i5lab/7DOF-Robotic-ARM/2nd Project (Build)/Report.pdf

a

# ساخت سه درجه آزادی اول

## universal

-UR5

فروغ افخمی 6003889

علی بهمنیار 6003880

سینا ربیعی 6003839

سمیرا سلجوقی 6003880

دکتر شریفی

زمستان 8888

ساخت ربات 2

## فهرست

## اهداف و فرآیند پروژه 3 انتخاب نحوه فیدبک و actuator 4

## انتخاب موتور 5 طراحی اجزای ربات در Solidworks 6

## پرینت سهبعدی و برش لیزری لینکها و صفحات 7 بخش مکانیکی پروژه 8

شفت 8
کوپلینگ 9
بلبرینگ 9
انواع پیچ و مهره و واشر 10

## مراحل ساخت ربات 11 بخش طراحی کنترلر پروژه 12

مراحل طراحی کنترل کننده 12

13 | Anti-wind up | عملکرد | نحوه
به دست آوردن ضرایب کنترلکننده 13

### 3 ساخت ربات

## اهداف و فرآیند پروژه

ربات پروژه ما ربات سری 9 درجه آزادی 5UR از شرکت universal است که در پروژه اول درس به شبیه سازی کامل آن در متلب پرداختیم و در پروژه عملی به ساخت ربات با 3 درجه آزادی اول آن می پردازیم و در ادامه با استفاده از کنترلر based-error آن را کنترل می کنیم.

مراحل این پروژه به شرح زیر می باشد:

- انتخاب نوع موتور مناسب و نحوه فیدبک گرفتن
- طراحی کامل اجزا و قسمت های ربات در نرم افزار solidworks
- پرینت سه بعدی قطعات
- خرید موتور ها و تجهیزات مورد نیاز
- ساخت ربات براساس طراحی
- برقراری ارتباط متلب با آردوینو
- ایجاد یک کنترل کننده based_error

ساخت ربات 4

## انتخاب نحوه فیدبک و actuator

برای کنترل موقعیت بازوی ربات، میبایست از یک سیستم کنترلی حلقه بسته استفاده شود، برای ایجاد این سیستم به یک فیدبک از موقعیت بازو نیازمندیم، برای ایجاد این فیدبک میتوانیم از روشهای زیر استفاده کنیم:

.8 انکودر چرخشی افزایشی)Encoder Incremental Rotary)

این نوع از انکودرها به ازای هر دور موتور تعدادی پالس روی دو فاز مختلف ایجاد میکنند، با شمارش تعداد این پالسها میتوان میزان چرخش موتور را تعیین کرد و با توجه به اختلاف فاز میان دو فاز میتوان جهت چرخش را مشخص نمود، این نوع فیدبک اما به صورت نسبی است به این معنا که تنها میتوان میزان تغییر موقعیت موتور را با استفاده از آن به دست آورد و موقعیت موتور را به صورت مطلق نمیتوان در اختیار داشت. در این روش میزان تغییر موقعیت موتور به صورت دقیق به دست میآید و این روش نسبت به نویز تا حد خوبی مقاوم است.

.0 پتانسیومتر)Potentiometer)

با استفاده از یک پتانسیومتر متصل به شفت موتور میتوان موقعیت شفت را با استفاده از تقسیم ولتاژ میان مقاومتها به صورت مطلق به دست آورد. با این که این روش موقعیت مطلق شفت را به ما میدهد و از این نظر مناسبتر است اما دارای دقت کمی است واز آن جا که عملاً موقعیت موتور میبایست به صورت آنالوگ مورد خوانش قرار گیرد این روش در برابر نویز حساسیت بیشتری دارد.

.3 انکودر چرخشی مطلق)Encoders Rotary Absolute)

انکودرهای مطلق با قابلیت خوانش دیجیتال که دقت بسیار مطلوبی را فراهم میکنند اما قیمت بسیار بالایی دارند.

در نهایت با توجه به محدودیتهای فیزیکی و مالی استفاده از روش دوم یعنی پتانسیومتر ترجیح داده شد، در این روش با هزینهی کم میتوانیم موقعیت شفت موتور را به صورت مطلق در اختیار داشته باشیم اما از طرف دیگر سیستم حساس به نویز خواهد بود و همچنین پتانسیومتر استفاده شده دارای حدوداً 88 تا 89 درجه dead zone میباشد، به این معنا که در این ناحیه خروجی ثابت مانده و با تغییر موقعیت شفت موتور سیستم قادر به تشخیص این تغییر نخواهد بود.

برای خواندن موقعیت موتور با استفاده از پتانسیومتر به واسطهی برد آردوینو )Mega Arduino )، از واحد ADC میکروکنترلر 2560ATmega استفاده میکنیم، این واحد ADC دارای دقت 10 بیتی است بنابراین میتوانیم به صورت تئوری موقعیت موتور را با دقت 360/1024 یعنی 0.351 درجه در اختیار داشته باشیم، اما نویز و zone dead باعث میشوند تا در عمل دقت کمتری داشته باشیم.

برای ایجاد نیروی محرکه میتوانیم از انواع موتورهای الکتریکی استفاده کنیم که موتورهای DC سادهترین آنها میباشند، در موتورهای DC، با تعیین جهت جریان عبوری از موتور میتوان جهت چرخش موتور را تعیین کرد.

### 5 ساخت ربات

برای کنترل توان تحویلی به موتور و نتیجتاً سرعت و گشتاور موتور نیز میتوان از پالس PWM با cycle Duty متغیر استفاده کرد.

برای کنترل جهت جریان عبوری از موتور میتوان از مدار Bridge-H استفاده کرد، با استفاده از این مدار میتوان جهت جریان عبوری از موتور را با ولتاژ مناسب موتور کنترل کرد.

آیسی 298L شرکت STMicroelectronics دارای دو مدار Bridge-H میباشد که برای استفادهی بیان شده بسیار مناسب میباشد.

## انتخاب موتور

موتور مورد نظر برای این پروژه سروو موتور R996 MG دنده فلزی 398 درجه دارای پتانسیومتر است. این موتور دارای مشخصات زیر می باشد که مقدار گشتاور، ابعاد و جرم آن برای پروژه مناسب می باشد. با توجه به نکات ذکر شده در بالا موتور R996MG گزینه مناسبی است زیرا در درون خود دارای فیدبک موقعیت از نوع پتانسیومتر نیز میباشد.برای کنترل این موتور، اتصال موتور به برد خود را قطع کرده ایم و از خروجی پتانسیومتر فیدبک میگیریم.

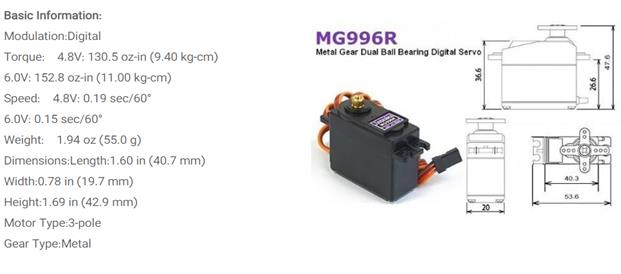
[picture p1: figure]

شکل :8 سرو موتور R996MG به همراه دیتاشیت خلاصه

ساخت ربات 6

## طراحی اجزای ربات در Solidworks

با استفاده از نرم افزار solidworks قسمت های مختلف ربات را با جزئیات کامل طراحی می کنیم. این طراحی شامل یک بیس برای ربات است که موتور اول زیر آن قرار می گیرد. در ادامه آن نیز لینک های دوم و سوم قرار می گیرند. همچنین محل قرار گیری بلبرینگ ها، شفت ها و سایر اتصالات نیز به طور دقیق مشخص می شوند.

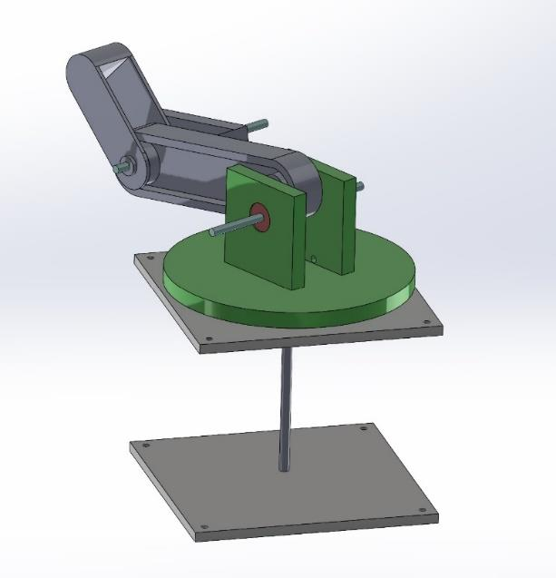
[picture p2: figure]

شکل :0 نمای ربات طراحی شده در Solidworks

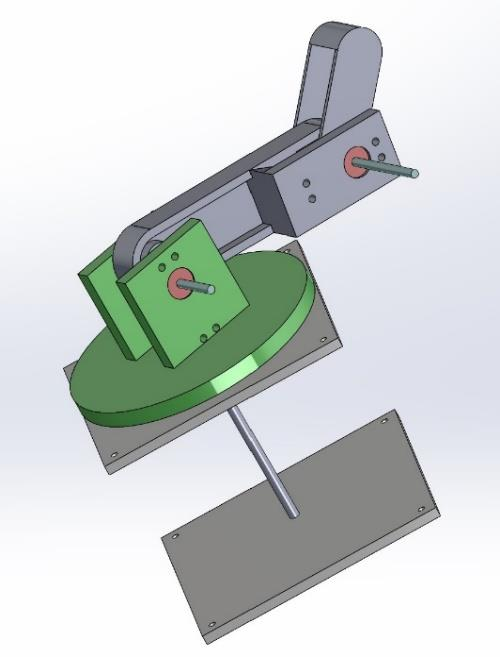
[picture p3: figure]

شکل :3 نمای ربات طراحی شده در Solidworks

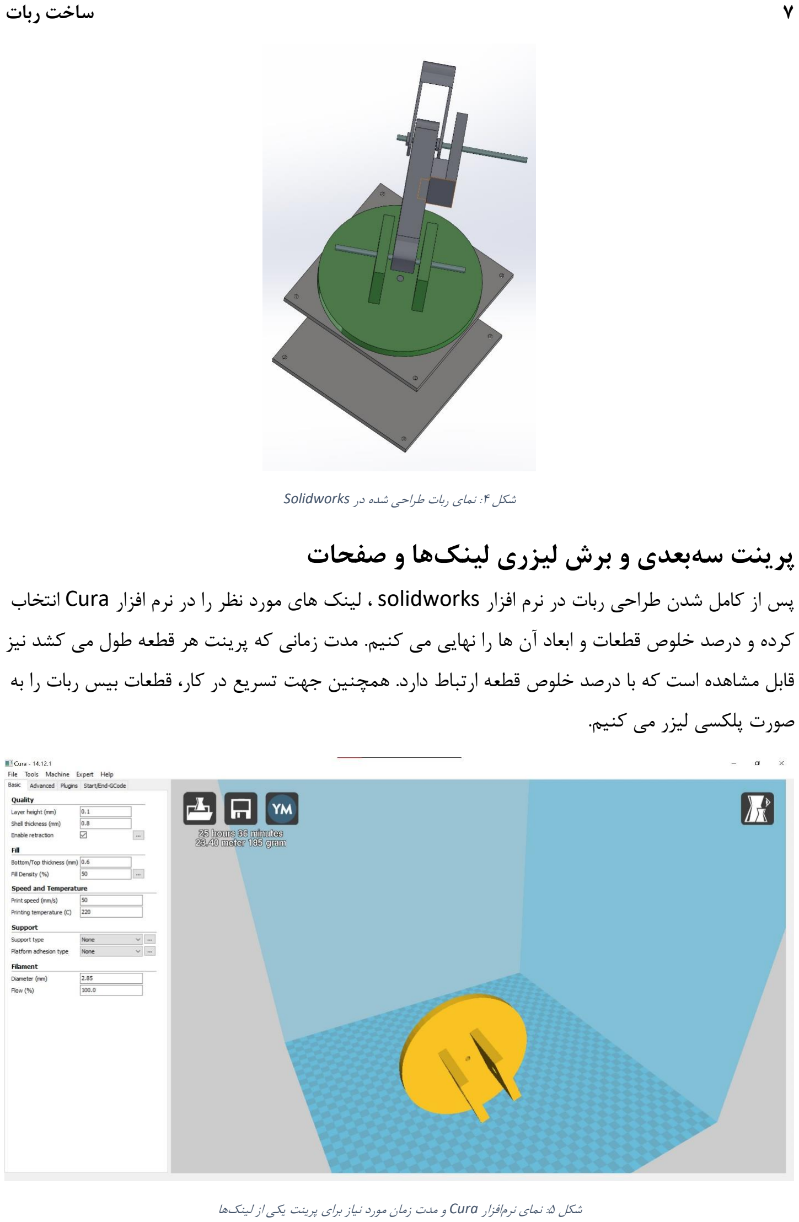
[picture p4: page 7]

### 7 ساخت ربات

شکل :8 نمای ربات طراحی شده در Solidworks

## پرینت سهبعدی و برش لیزری لینکها و صفحات

پس از کامل شدن طراحی ربات در نرم افزار solidworks ، لینک های مورد نظر را در نرم افزار Cura انتخاب کرده و درصد خلوص قطعات و ابعاد آن ها را نهایی می کنیم. مدت زمانی که پرینت هر قطعه طول می کشد نیز قابل مشاهده است که با درصد خلوص قطعه ارتباط دارد. همچنین جهت تسریع در کار، قطعات بیس ربات را به صورت پلکسی لیزر می کنیم.

شکل :9 نمای نرمافزار Cura و مدت زمان مورد نیاز برای پرینت یکی از لینکها

ساخت ربات 8

## بخش مکانیکی پروژه

تجهیزات مکانیکی استفاده شده

.8 شفت
.0 کوپلینگ
.3 بلبرینگ
.8 انواع پیچ و مهره و واشر

شفت
به سه عدد شفت هارد کروم به قطر 9 میلیمتر نیاز داریم تا موتورها را به لینکها متصل کنیم. شفتهای تهیه شده ساخت چین و دارای مشخصات زیر هستند:

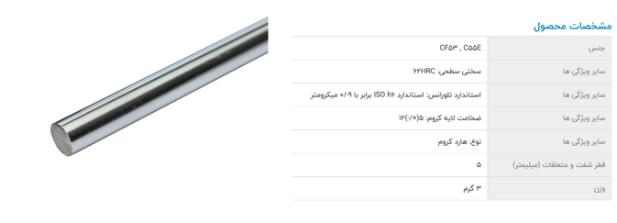
[picture p5: figure]

شکل :9 شفت هاردکروم 9 میلیمتر

### 9 ساخت ربات

کوپلینگ
به سه عدد کوپلینگ 9 به 9 میلیمتر نیاز داریم که دارای مشخصات زیر هستند:

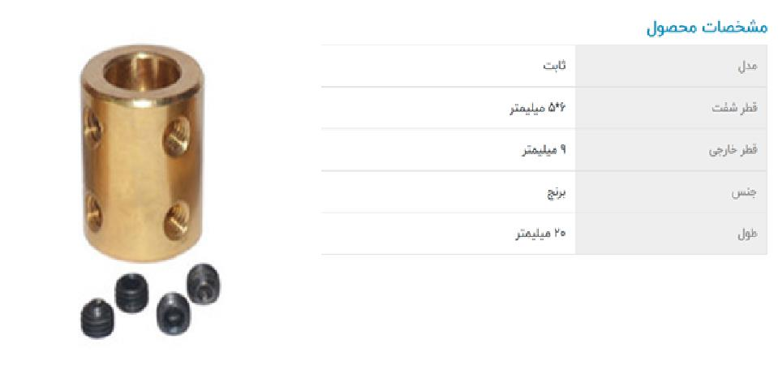
[picture p6: figure]

شکل :7 کوپلینگ 9 به 9 برنجی
بلبرینگ
به شش عدد بلبرینگ شیار عمیق فلنج دار نیاز داریم که دارای مشخصات زیر هستند:

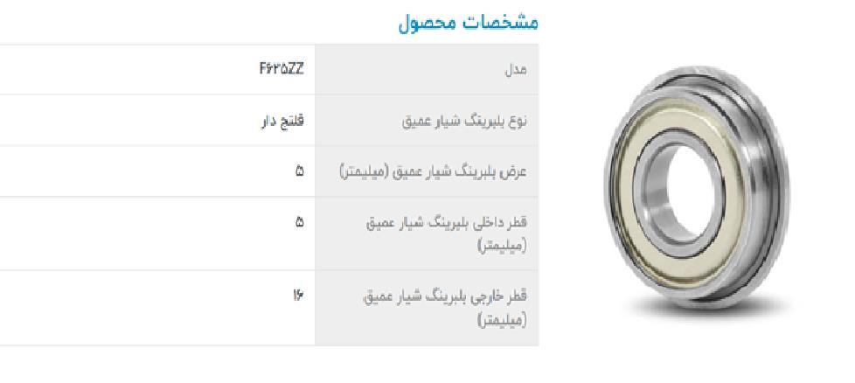
[picture p7: figure]

شکل :0 بلبرینگ قطر 9 میلیمتر

ساخت ربات 11

انواع پیچ و مهره و واشر
برای اتصال صفحات مربعی بیس به پیچ متری با قطر 8 میلی متر )4M )نیاز داریم که به اندازه یک متر تهیه شده.

همچنین برای سایر اتصالات از پیچ و مهره و واشر به قطر 8 میلیمتر به مقدار لازم استفاده می کنیم.

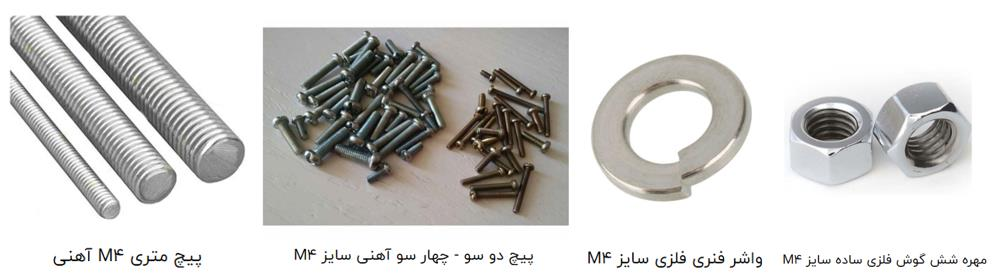
[picture p8: figure]

شکل :6 پیچ و مهرههای استفاده شده

### 11 ساخت ربات

## مراحل ساخت ربات

شفتها و پیچمتریها در ابعاد خاصی موجود هستند در نتیجه آنها را به اندازههای مورد نیازمان با فرز و تیغهاره برش میدهیم. در ادامه برای پرس کردن شفتها و بلبرینگها به دلیل اینکه در پرینت قطعات حدود 8.3-8.8 میلیمتر امکان خطا دارند، میتوان در صورت نیاز از سمباده یا چسب )برای از بین بردن لقی( استفادهکرد.

ارتفاع لینک اول را نسبت به بیس با پیچ متریهای 09 سانتیمتر تنظیم میکنیم. در نهایت نیز لینک ها را مطابق با طراحی انجام شده در Solidworks به یکدیگر متصل میکنیم.

ساخت ربات 12

## بخش طراحی کنترلر پروژه

مراحل طراحی کنترل کننده
میخواهیم یک کنترل کننده based_error برای ربات با استفاده از Simulink MATLAB طراحی کنیم. به
این منظور ابتدا لازم است تا دو پکیج Arduino for package support MATLAB و support
Arduino for package Simulink را نصب کرده و سپس از بلوکهای موجود در آن برای برنامهریزی برد استفاده میشود.

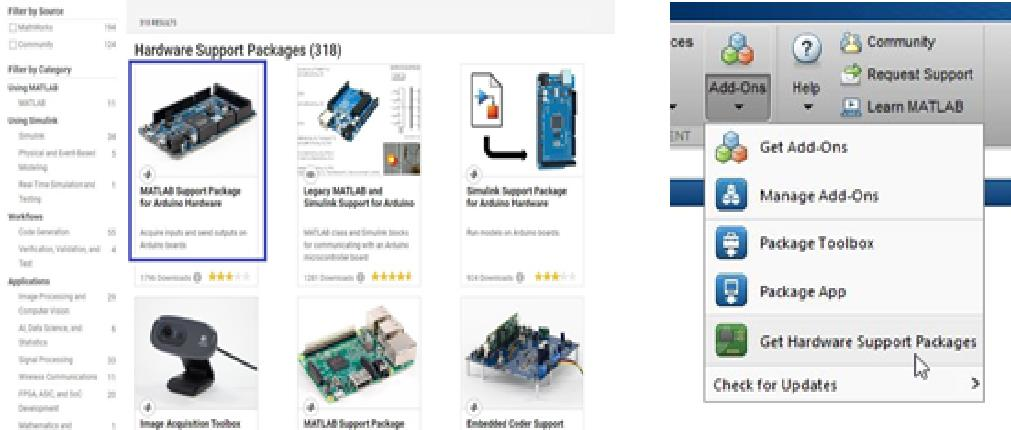
[picture p9: figure]

شکل :88 تصاویر محیط اضافه کردن پکیج آردینو در Simulink
بعد از آنکه موفق شدیم ارتباط متلب با برد آردوینو را برقرار کنیم، بلوک دیاگرام کنترلر based_error که مطابق شکل زیر می باشد را طراحی میکنیم:

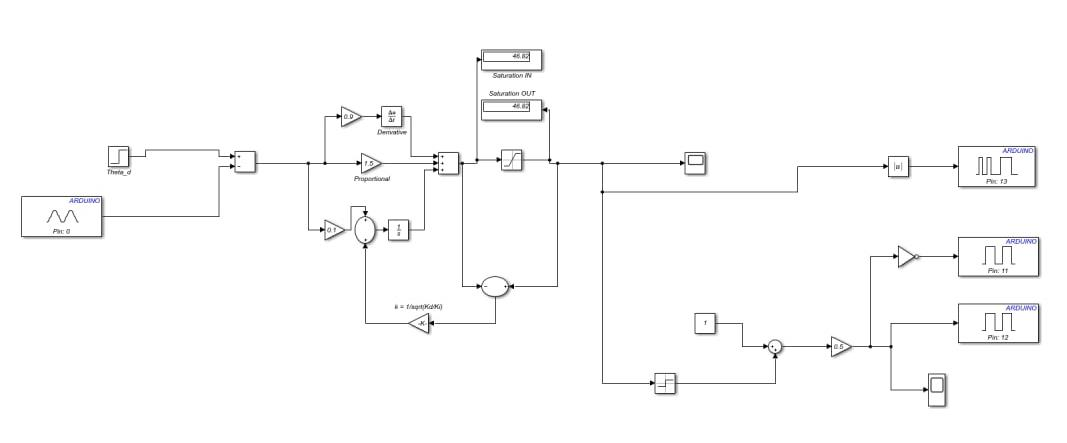
[picture p10: figure]

شکل :88 بلوک دیاگرام کنترلر based_error
در ورودی مقدار زاویه مورد نظر )desired )داده شده و از پین آنالوگ آردوینو متصل به پتانسیومتر فیدبک گرفته میشود. در ادامه کنترلر شامل ضریب تناسبی )proportional)، قسمت مشتقگیر و بخش انتگرالگیر به همراه windup-anti است که نحوه عملکرد بخش انتگرالگیر به همراه windup-anti در ادامه شرح داده میشود. همچنین در انتهای بلوک دیاگرام مقدار مطلق خروجی کنترلر به بلوک PWM میکروکنترلر داده میشود تا همانطور که در قسمتهای قبلی شرح داده شد توان تحویلی به موتور به صورت مناسب کنترل گردد.

### 13 ساخت ربات

همچنین برای تعیین جهت چرخش موتور متناسب با علامت خروجی کنترلر، خروجی پینهای متصل به درایور موتور(298L )با استفاده از واحد خروجی دیجیتال میکروکنترلر تعیین میگردد.

Anti-wind up | عملکرد | نحوه
در بسیاری از فرآیندها فرمان کنترل کننده از سقف اشباع بالاتر می رود و چون کنترل کنندهها دارای محدویت میباشند در عمل حلقه فیدبک کارایی خود را از دست می دهد.

عاملی که بیشترین تاثیر در به اشباع رفتن کنترلکننده دارد ترم انتگرالگیر میباشد. بخاطر عمل انتگرالگیری، خطا روی هم انباشته شده و ممکن است از حد اشباع عبور کند. به این فرآیند جمعشوندگی یا Windup گفته میشود.

اگر جلوی جمعشوندگی گرفته نشود چون زمان زیادی نیاز است تا خطای منفی جمع گردد و اثر جمعشوندگی را از بین ببرد پاسخ سیستم خیلی کند شود و ناپایدار میشود. در این حالت کنترلکننده نمیتواند ورودی را دنبال کند.
روشهای زیادی برای جلوگیری از جمعشوندگی )up wind-Anti )ارائه شدهاست که به دو صورت آنالوگ و دیجیتال قابل پیادهسازی میباشد.

ایده اصلی تمام روشهای windup-Anti این است که زمانی که کنترلکننده به اشباع میرود، چون انتگرالگیری از خطا تاثیری ندارد پس بهتر است که انتگرال گیر خاموش شود. بصورت دیجیتالی کافی است که اگر مقدار خروجی کنترلکننده از ماکزیمم خود بیشتر شد مقدار انتگرالگیر را صفر کنیم. به دست آوردن ضرایب کنترلکننده
پس از تکمیل بلوک دیاگرام اتصالات موتور، درایور، منبع تغذیه و برد آردوینو را برقرار کرده و سپس با تست کردن بر روی موتور و مشاهده رفتار آن به ازای مقادیر مختلف ضرایب کنترلکننده، سعی میکنیم تا بهترین ضرایب را به دست آوریم، به طوری که سرعت موتور و خطای حالت دائم آن مناسب باشد و اورشوت ناچیزی داشته باشد.

در این کنترلر ابتدا ضریب تناسبی را تنظیم میکنیم تا پاسخ سیستم با سرعت مناسب به مقدار مطلوب برسد. اما پس از تنظیم این ضریب، سیستم نوسان و اورشوت پیدا خواهد کرد که برای از بین بردن نوسانات، ضریب مشتقگیر و برای کاهش خطای حالت دائم ضریب انتگرالگیر را تنظیم می کنیم.

با مشاهده نحوه عملکرد پتانسیومتر و موتور و با تنظیم و تست ضرایب مختلف و با در نظر گرفتن ناحیه مرده )zone Dead )موتور و پتانسیومتر و ناحیه اشباع میتوان ضرایب کنترلر را به نحوی به دست آورد تا ربات زاویه یا ترجکتوری مورد نظر را با سرعت مناسب و با اورشوت ناچیز به صورت پایدار دنبال کند.

ساخت ربات 14
همانطور که ذکر شد خروجی پتانسیومتر میبایست به صورت آنالوگ نمونهبرداری شود و درنتیجه حساسیت به نویز به در این سیستم قابل توجه خواهد بود که عدم وجود مدار چاپی )PCB )و اتصالات بلند نیز این مسأله را تشدید خواهد کرد. بنابر دلایل بیان شده، نیاز است که از فیلتر در ورودی فیدبک استفاده کنیم. در غیر این صورت، به دلیل وجود ترم مشتقگیر در کنترلر، نویز موجود در سیستم تقویت شده و همچنین تأخیر در سیستم نیز نمود بیشتری پیدا میکند و باتوجه به نکات ذکر شده امکان استفاده از مد Tracking وجود نخواهد داشت.

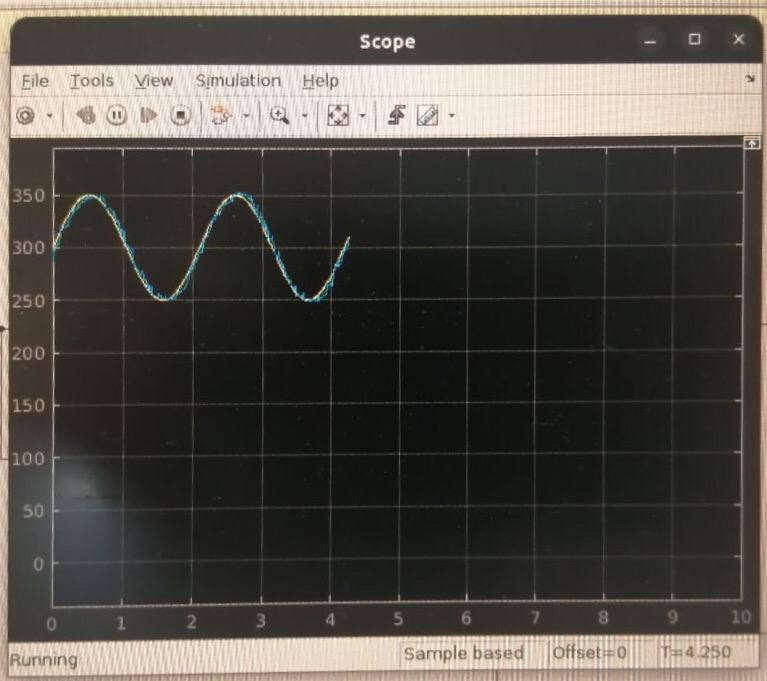
[picture p11: figure]

شکل :80 خروجی Simulink برای دنبال کردن یک موج سینوسی
موج زرد رنگ مربوط به سیگنال ورودی)desired )است که میخواهیم دنبال کنیم و موج آبی، موقعیت شفت در عمل را نشان میدهد.
