i5lab/7DOF-Robotic-ARM/2nd Project (Build)/SolidWorks/Assem1.SLDASM

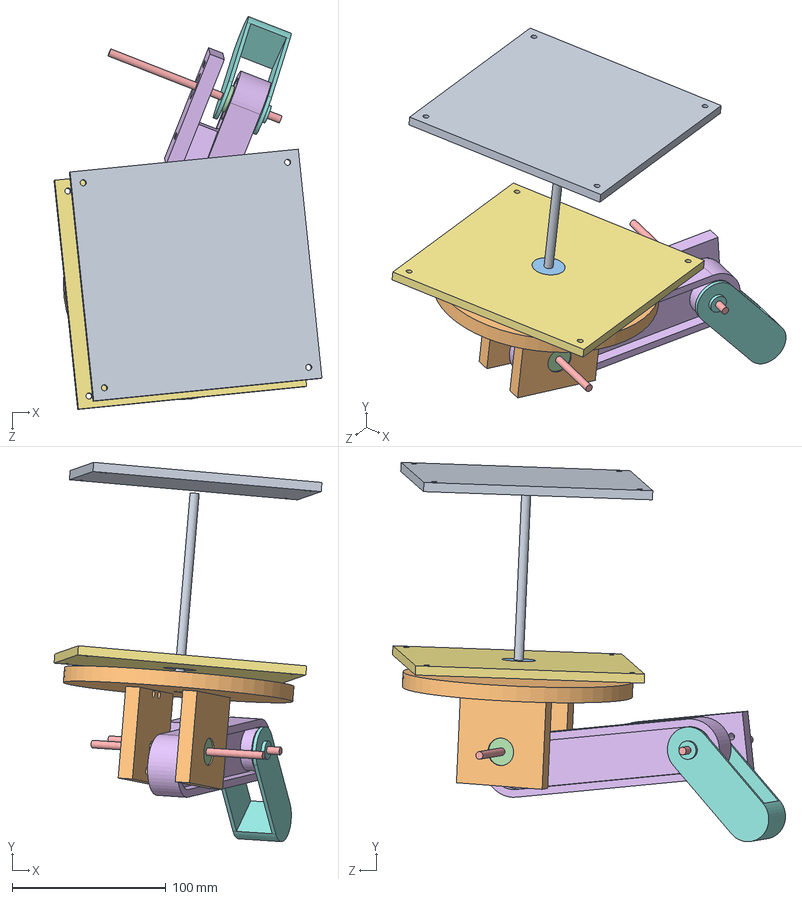
[picture p12: CAD file, 2022-08-15]
2nd Project (Build)/SolidWorks/Assem1.SLDASM
174.6 x 247.1 x 256.0 mm
Shaft 6mm
Base1
Ball Bearing 6mm
Ball Bearing 5mm x 5
Shaft 5mm x 2
Link1
Bed1
Link2
Bed
