i5lab/7DOF-Robotic-ARM/2nd Project (Build)/SolidWorks/Link1.SLDPRT

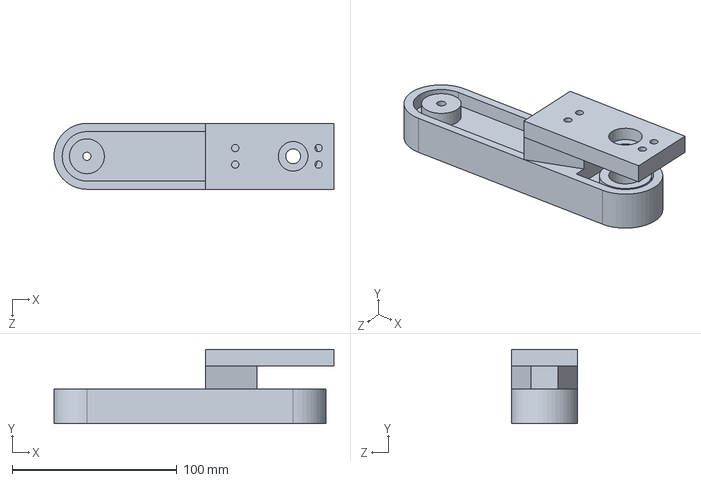
[picture p13: CAD file, 2022-08-15]
2nd Project (Build)/SolidWorks/Link1.SLDPRT
169.7 x 45.0 x 40.2 mm
