i5lab/7DOF-Robotic-ARM/2nd Project (Build)/SolidWorks/Pully.SLDPRT

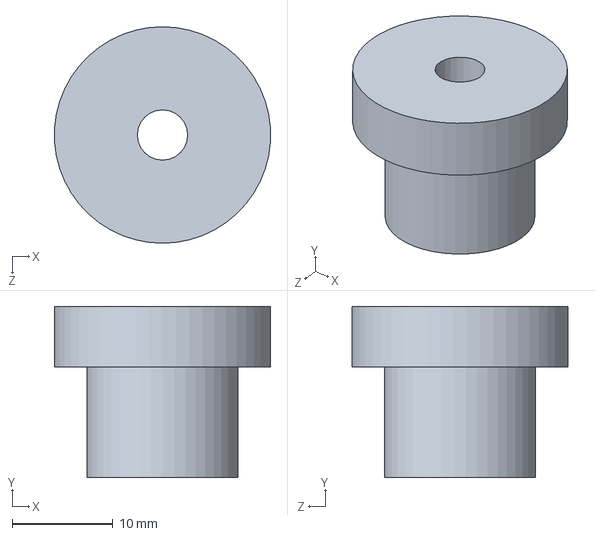
[picture p14: CAD file, 2022-08-15]
2nd Project (Build)/SolidWorks/Pully.SLDPRT
21.5 x 17.0 x 21.5 mm
