i5lab/7DOF-Robotic-ARM/2nd Project (Build)/SolidWorks/Ball Bearing 6mm.SLDPRT

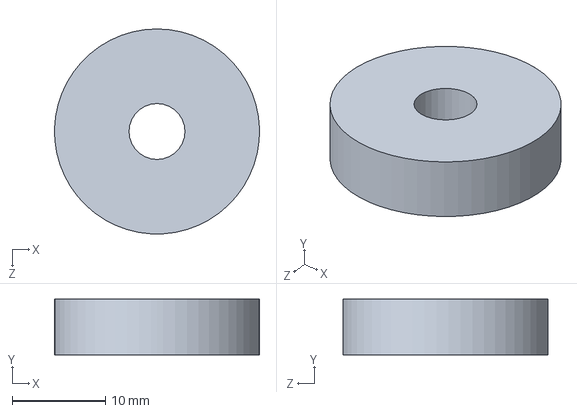
[picture p15: CAD file, 2022-08-15]
2nd Project (Build)/SolidWorks/Ball Bearing 6mm.SLDPRT
22.0 x 6.00 x 22.0 mm
