i5lab/7DOF-Robotic-ARM/2nd Project (Build)/SolidWorks/Conect.SLDPRT

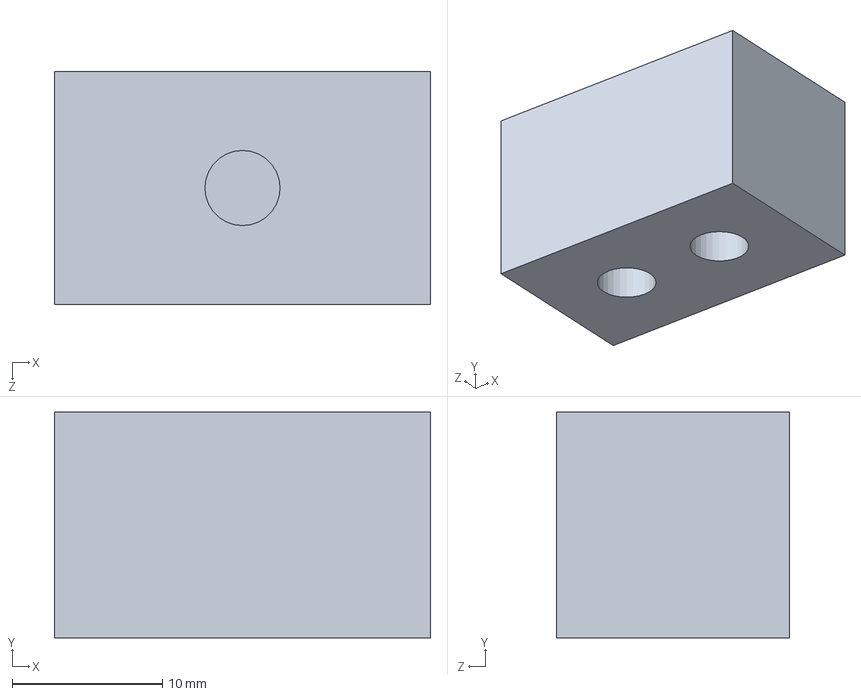
[picture p16: CAD file, 2022-08-15]
2nd Project (Build)/SolidWorks/Conect.SLDPRT
25.0 x 15.0 x 15.5 mm
