i5lab/7DOF-Robotic-ARM/2nd Project (Build)/SolidWorks/Couple 6 5.SLDPRT

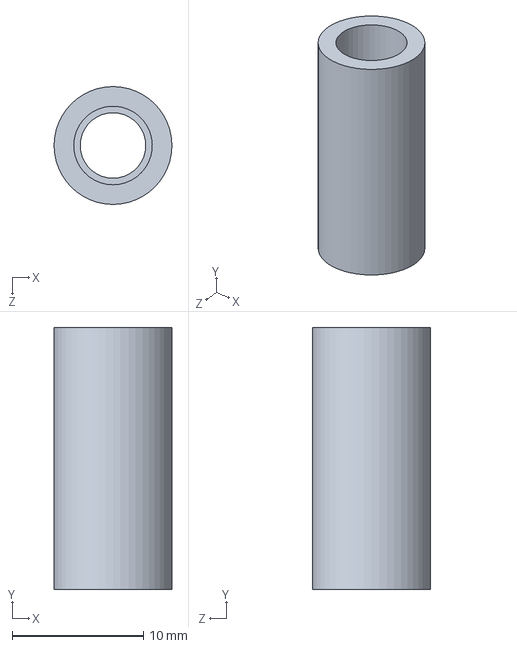
[picture p17: CAD file, 2022-08-15]
2nd Project (Build)/SolidWorks/Couple 6 5.SLDPRT
9.00 x 20.0 x 9.00 mm
