i5lab/7DOF-Robotic-ARM/2nd Project (Build)/SolidWorks/Link2.SLDPRT

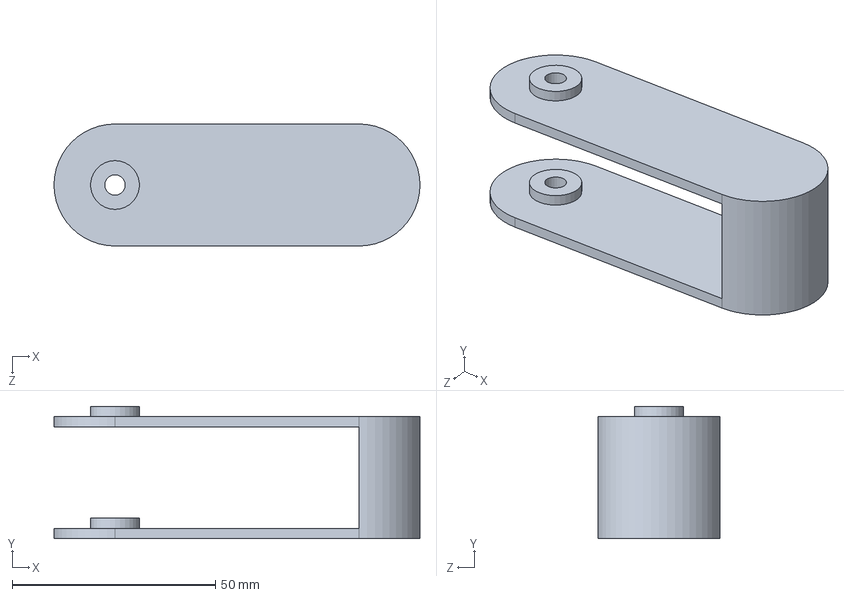
[picture p18: CAD file, 2022-08-15]
2nd Project (Build)/SolidWorks/Link2.SLDPRT
90.0 x 32.5 x 30.0 mm
