i5lab/7DOF-Robotic-ARM/2nd Project (Build)/SolidWorks/Shaft 5mm.SLDPRT

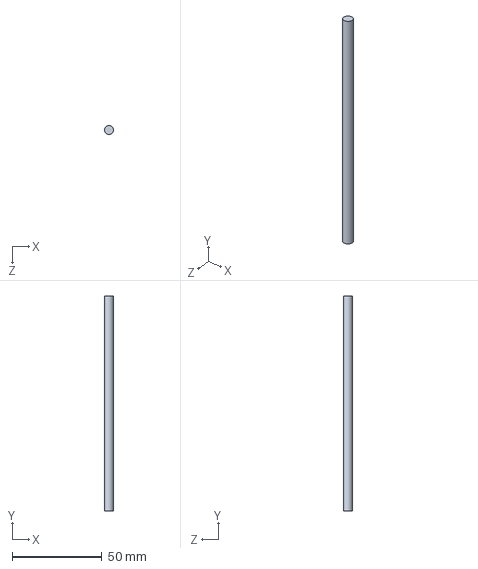
[picture p19: CAD file, 2022-08-15]
2nd Project (Build)/SolidWorks/Shaft 5mm.SLDPRT
5.00 x 120.0 x 5.00 mm
