i5lab/7DOF-Robotic-ARM/2nd Project (Build)/SolidWorks/Bed.SLDPRT

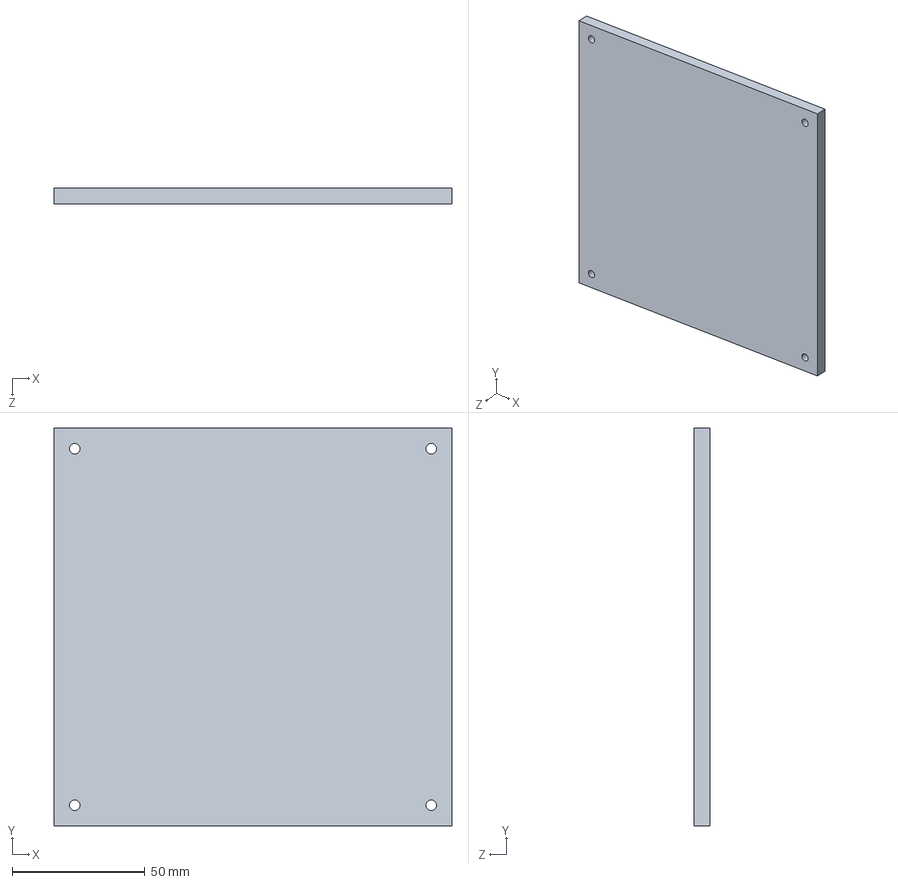
[picture p20: CAD file, 2022-08-15]
2nd Project (Build)/SolidWorks/Bed.SLDPRT
150.0 x 150.0 x 6.00 mm
