i5lab/7DOF-Robotic-ARM/2nd Project (Build)/SolidWorks/Ball Bearing 5mm.SLDPRT

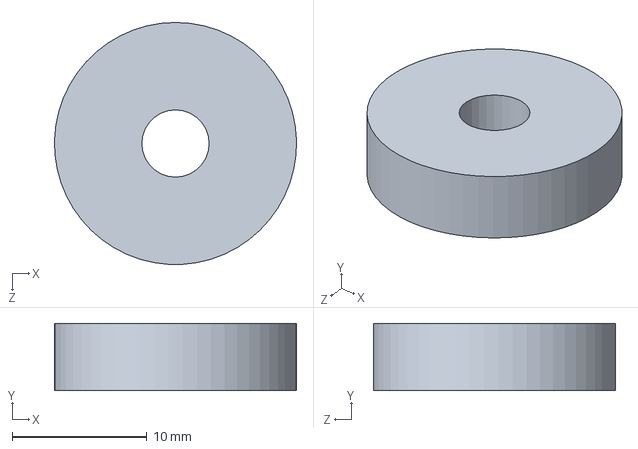
[picture p22: CAD file, 2022-08-15]
2nd Project (Build)/SolidWorks/Ball Bearing 5mm.SLDPRT
18.0 x 5.00 x 18.0 mm
