i5lab/7DOF-Robotic-ARM/2nd Project (Build)/SolidWorks/Shaft 6mm.SLDPRT

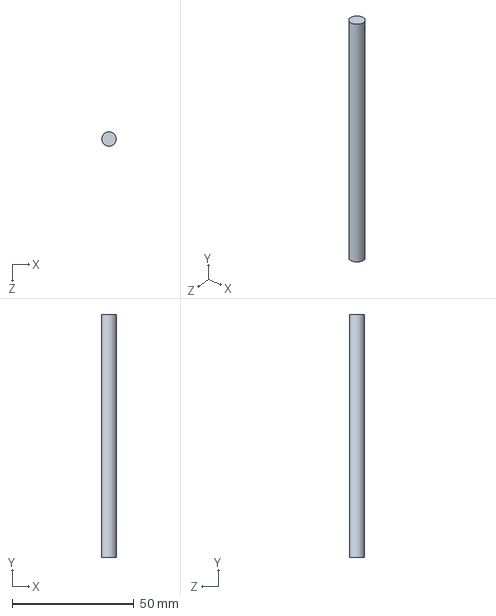
[picture p23: CAD file, 2022-08-15]
2nd Project (Build)/SolidWorks/Shaft 6mm.SLDPRT
6.00 x 100.0 x 6.00 mm
