i5lab/7DOF-Robotic-ARM/2nd Project (Build)/SolidWorks/Base1.SLDPRT

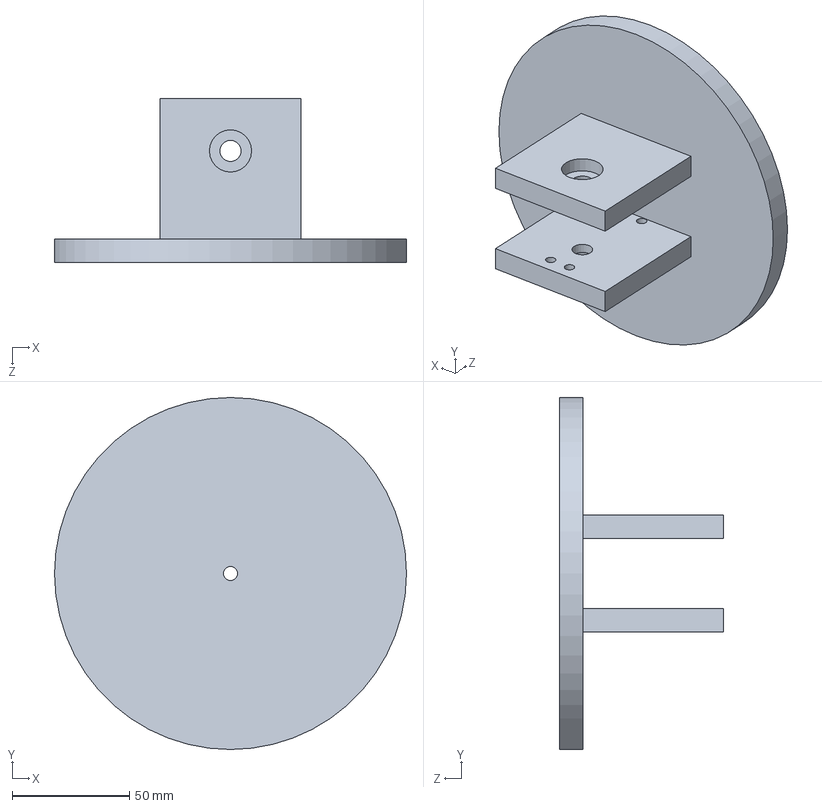
[picture p24: CAD file, 2022-08-15]
2nd Project (Build)/SolidWorks/Base1.SLDPRT
150.0 x 150.0 x 70.0 mm
