i5lab/7DOF-Robotic-ARM/2nd Project (Build)/SolidWorks/Couple 6.35 6.SLDPRT

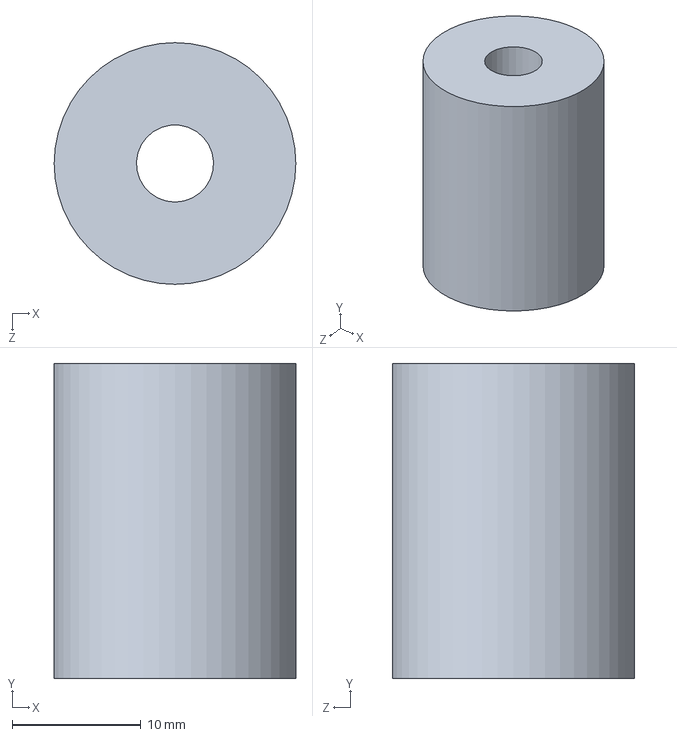
[picture p25: CAD file, 2022-08-15]
2nd Project (Build)/SolidWorks/Couple 6.35 6.SLDPRT
18.8 x 24.5 x 18.8 mm
