i5lab/7DOF-Robotic-ARM/2nd Project (Build)/SolidWorks/Shaft 5mm 20.SLDPRT

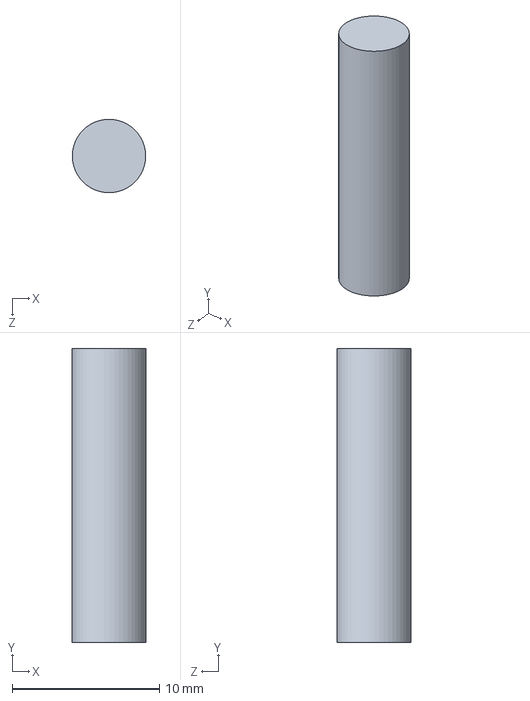
[picture p26: CAD file, 2022-08-15]
2nd Project (Build)/SolidWorks/Shaft 5mm 20.SLDPRT
5.00 x 20.0 x 5.00 mm
